adover06/esp32-obdii-OVBS/dash_previews/esp32_dual_dials.png

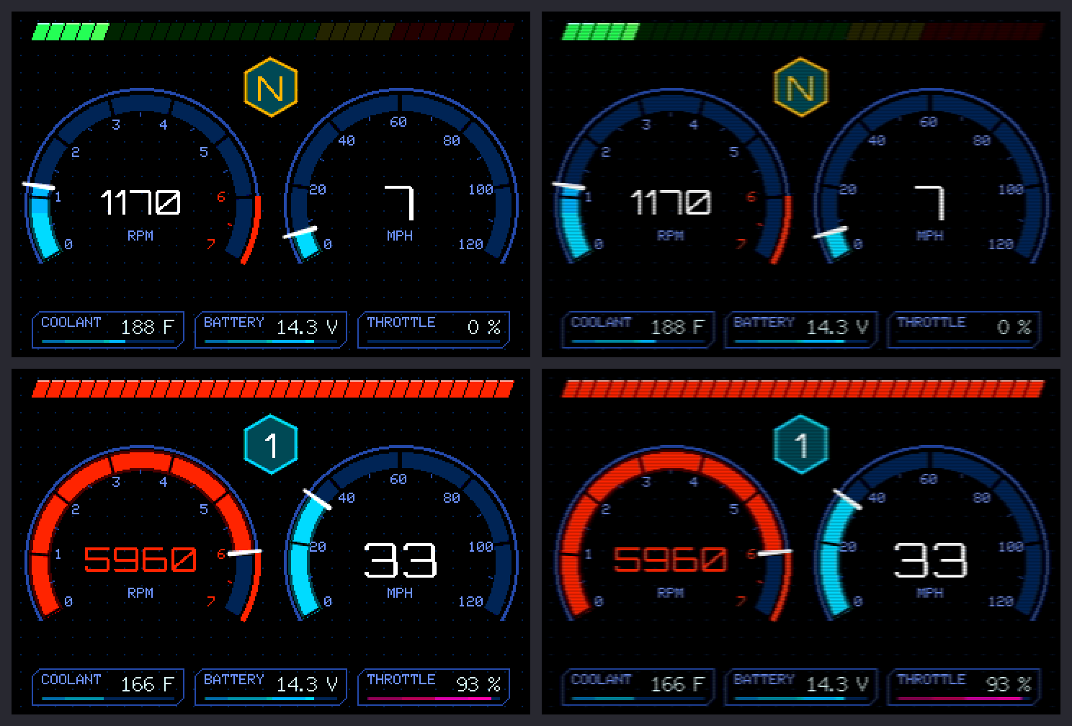
dash_previews/esp32_dual_dials.png
