adover06/esp32-obdii-OVBS/dash_previews/esp32_live_screens.png

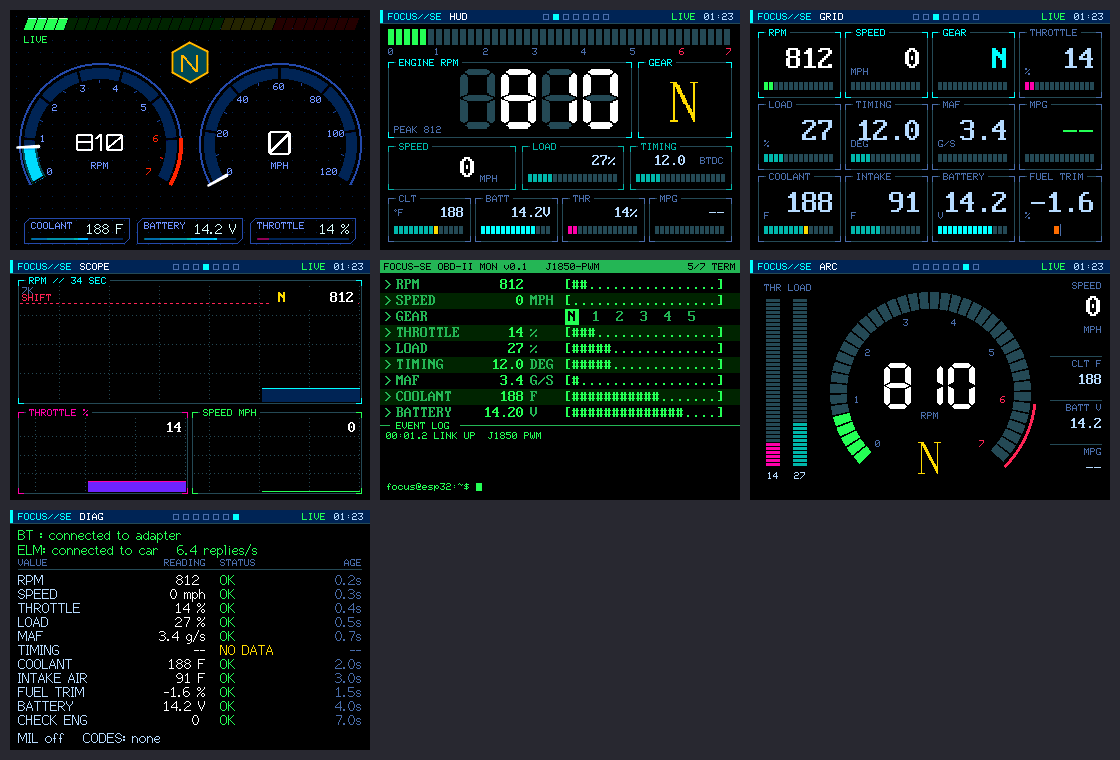
dash_previews/esp32_live_screens.png
