adover06/esp32-obdii-OVBS/dash_previews/esp32_simple.png

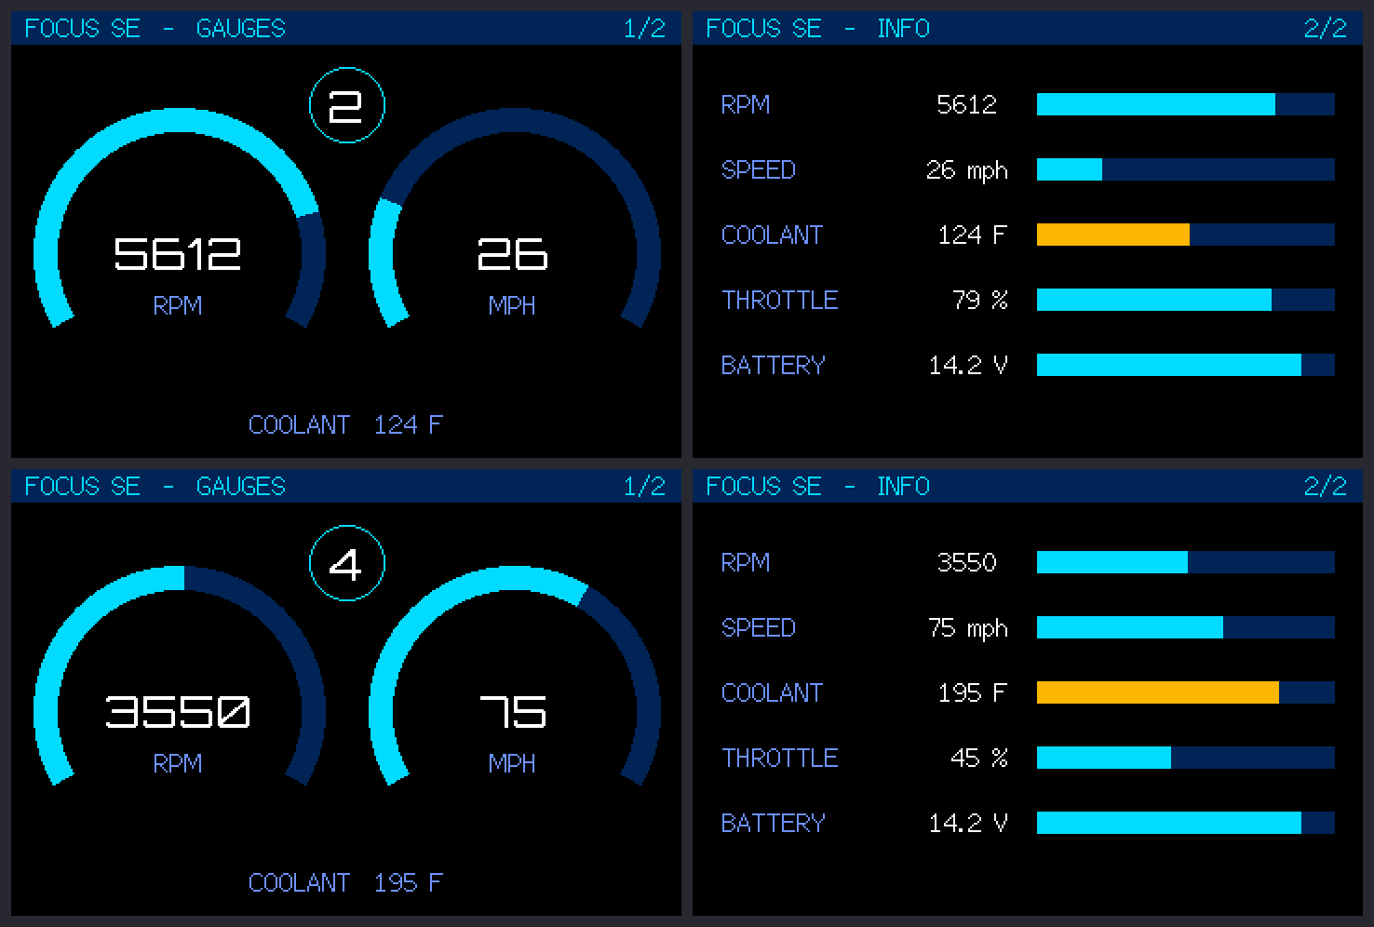
dash_previews/esp32_simple.png
