adover06/esp32-obdii-OVBS/dash_previews/esp32_w360_cvbs.png

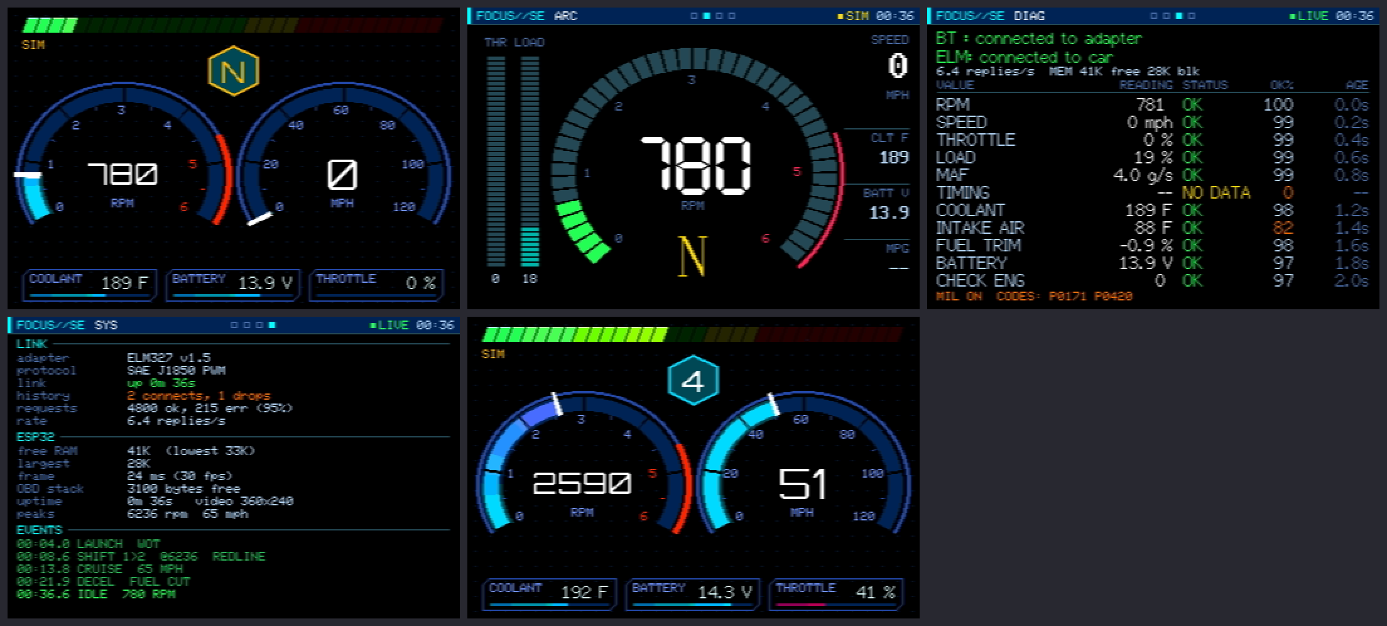
dash_previews/esp32_w360_cvbs.png
