adover06/esp32-obdii-OVBS/dash_previews/uno_screens.png

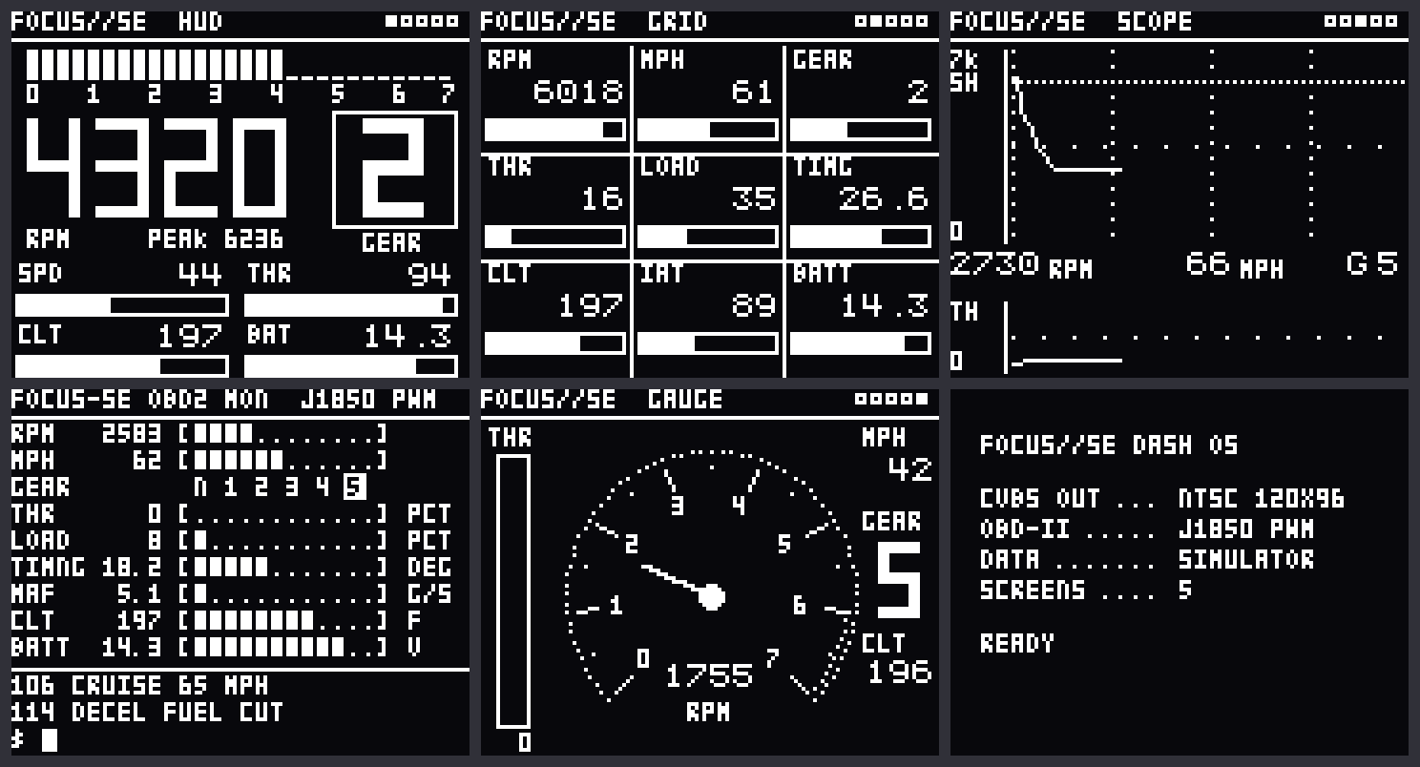
dash_previews/uno_screens.png
