adover06/esp32-obdii-OVBS/dash_previews/uno_screens_redline.png

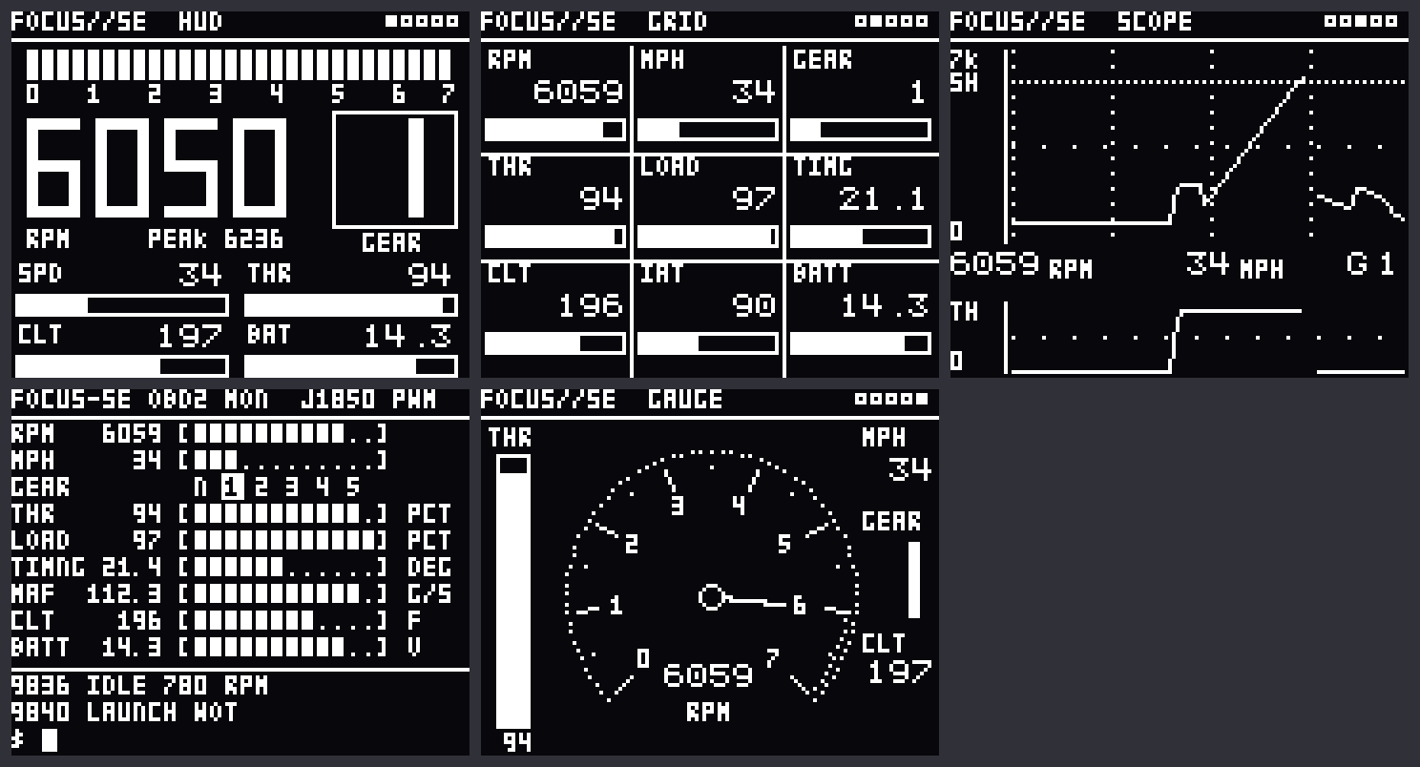
dash_previews/uno_screens_redline.png
