adover06/esp32-obdii-OVBS/(commit log)

2026-10-01 ESP32 OBD-II composite video dashboard
    ESP32 (WROOM-DA) reads a 2000 Ford Focus over a Bluetooth ELM327
    (J1850 PWM) and draws the dashboard as composite video on GPIO25.
    - esp32_dash: 7 screens, live OBD data on a background task, DIAG
    screen, fake-data simulator; currently a 320x200 no-canvas memory
    test because video + Bluetooth nearly fill the WROOM's RAM
    - esp32_obd_test: per-value status/debug test (confirmed working in car)
    - esp32_simple: beginner two-screen version with getter functions
    - uno_dash: black-and-white TVout version for the Uno
    - dash_preview_app: runs the ESP32 drawing code on macOS via SDL
2026-10-02 Fix boot loop; strip renderer, 240x240 layouts, OBD fixes, validation tools
    Boot loop cause: LovyanGFX drawWedgeLine/drawWideLine replace the clip rect
    with their own bounding box, so the dual-dial screen wrote ~44 KB outside the
    drawing buffer and corrupted the heap. Replaced with dash::wedge().
    - render.h: strip renderer (24-row bands, 5.8 KB buffer) instead of an 86 KB
    full-frame canvas; guard bytes detect escapes at runtime
    - 240x240 picture without PSRAM, 360x240 with PSRAM (picture in PSRAM)
    - all 7 screens laid out from the screen width, aspect-correct dials
    - drawing is stateless; dual-dial smoothing moved to fx::updateDual()
    - obd.h: fix ELMduino payload leak on every reconnect,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
    [dash.h, dash_fx.h, esp32_dash.ino, obd.h, render.h]
2026-10-02 Trim to 4 screens, add SYS page, hotter RPM thresholds
    - keep DUAL, ARC, DIAG; archive HUD/GRID/SCOPE in esp32_dash/archive/
    (not compiled); remove TERM and the graph history (-2.6 KB static RAM)
    - new SYS screen: adapter version/protocol (ATI/ATDP), link uptime,
    connects/drops, request totals, free + lowest-ever heap, largest block,
    frame time, OBD stack headroom, peaks, recent events
    - DIAG: per-value success rate (OK%) on wide screens
    - RPM feel: dial scale 6000, yellow 3200, orange 4000, red/flash 4600,
    all from one tunable block; dial/shift-bar gradients and ARC follow it
    - validate.sh: covers the new screens, snapshots across the drive
2026-10-02 Add MAX1000 FPGA video card and ESP32 link test
    FPGA (fpga/): SPI slave, SDRAM double-buffered 360x240 RGB332 frame
    buffers, 4fsc NTSC 240p composite encoder through a 6-bit R-2R DAC,
    power-up SDRAM self test, plus blink and colour-bar test designs.
    Quartus Lite runs in Docker; programming via openFPGALoader (.svf).
    Simulation (fpga/projects/sim) checks every SDRAM rule and every
    composite sample across board-delay corners.
    ESP32 (esp32_fpga_test/): link speed test with FPGA-side CRC check and
    an animated 360x240 scene streamed in DMA-overlapped bands.
2026-10-04 FPGA video at 720x240, dashboard in FPGA mode, shift lights
    FPGA (fpga/):
    - 720x240: one 14.3 MHz sample per pixel, each line spans two SDRAM rows,
    1024-word line buffer, 27-bit write FIFO entries, wider test pattern
    - refresh may run between a line's two row reads; 9.8 us interval
    (worst gap 14.2 us in simulation, spec 15.6 us)
    - DAC moved to MKR J2 (D6-D10, D13) so the board fits a breadboard
    - levels retuned for a 270 ohm ladder; white at 100 IRE
    - quartus.sh flash: write the design to the MAX 10 internal flash
    - simulation: SDRAM model address width fixed for 1024 rows, testbench
    and checker updated for 720 wide; all corners pass
    ESP32 dashboard (esp32_dash/):
    - OUTPUT_FPGA mode: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
    [check_video.py, cmd_parser.v, colorbars.v, dash.h, dash_fx.h, esp32_dash.ino, esp32_shift_light_test.ino]
2026-10-05 Single-ESP32 mode: TinySPP Bluetooth client, 360x240, 7x faster dials
    - tiny_spp.h: our own minimal Bluetooth Classic SPP client on the radio's
    HCI interface (VHCI), replacing Arduino's BluetoothSerial/Bluedroid.
    Connect by address, legacy PIN pairing, L2CAP, RFCOMM with credit flow,
    Arduino Stream interface for ELMduino. Keeps the core from freeing the
    Classic controller memory at boot (btClassicInUse). Measured +80 KB free
    heap and half the program size; TINY_BT false restores BluetoothSerial.
    - Drawing: one-pass gradient ring (dial value arcs) and segmented ring (ARC
    tach) rasterizers replace hundreds of per-slice arc fills. DUAL at high
    RPM went from ~300 ms to ~40 ms per f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
    [dash.h, dash_fx.h, esp32_dash.ino, esp32_fake_elm327.ino, obd.h, render.h, tiny_spp.h]
2026-10-05 Switches, sport mode, WS2812 shift-light sticks; single-ESP32 default
    - Switches (internal pull-ups, debounced 30 ms): GPIO27 latching screen
    switch (every flip, either way = next screen, compared to its last
    state), GPIO16 RPM-array on/off, GPIO17 sport mode; states read at boot.
    - Sport mode: RPM zones are runtime values with NORMAL (2600/3200/3800)
    and SPORT (3600/4400/5000) sets; fx::setSport() moves the dial and
    shift-bar gradients, the ARC redline band, the shift flash and the LED
    bar; SPORT badge on the header and the DUAL screen. Validator covers both.
    - shift_light.h: WS2812B/SK6812 stick support (default) with our own RMT
    driver: one data wire for chained sticks, RPM ba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
    [dash.h, dash_fx.h, esp32_dash.ino, shift_light.h, tiny_spp.h]
2026-10-05 Track esp32_dac_check (GPIO25 DC step test for the video wiring)
2026-10-05 Add esp32_dash_final: the car build with unused paths removed
    One ESP32 (video on GPIO25, 360x240), TinySPP Bluetooth, WS2812 shift-light
    sticks, latching screen switch, RPM-lights and sport switches, startup
    sweep. Removed: FPGA output, BluetoothSerial fallback, LM3914/RGB driver,
    PSRAM branch, profiling timers. esp32_dash keeps every option.
2026-10-06 status LEDs
